nakedninja-design/Wifi-Plant-Watering-System/STL files Boxy/Box.stl

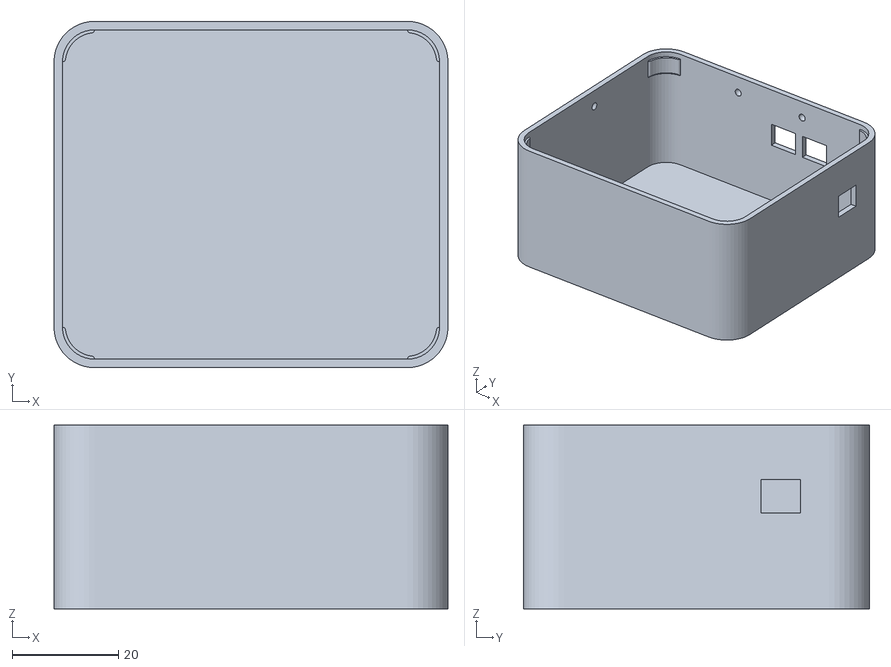
[picture p1: CAD file, 2020-06-12]
STL files Boxy/Box.stl
74.2 x 65.2 x 34.6
