nakedninja-design/Wifi-Plant-Watering-System/STL files Toby/Push Buttons.stl

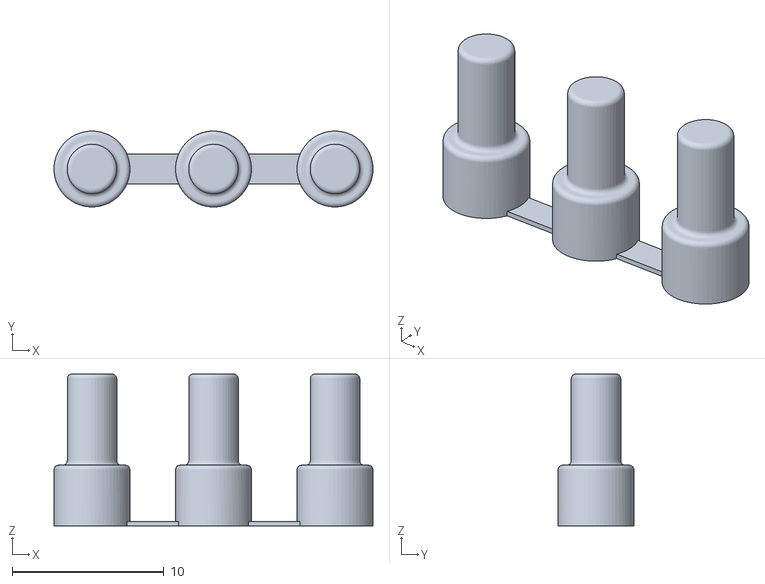
[picture p2: CAD file, 2020-06-12]
STL files Toby/Push Buttons.stl
21.0 x 5.00 x 10.00
