nakedninja-design/Wifi-Plant-Watering-System/STL files Boxy/Front.stl

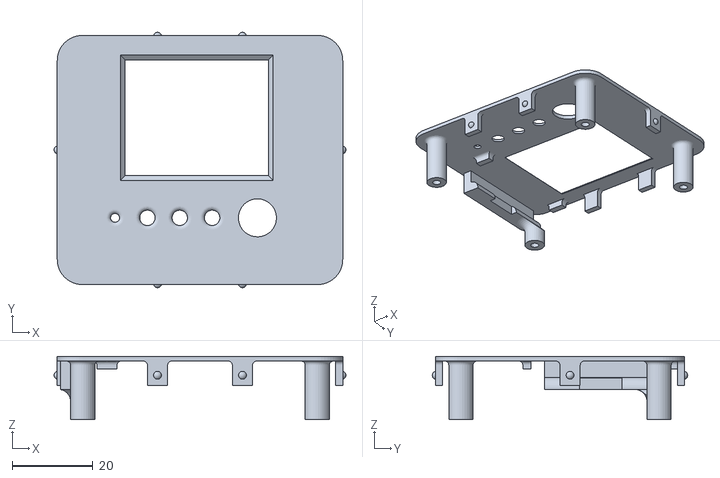
[picture p3: CAD file, 2020-06-12]
STL files Boxy/Front.stl
72.2 x 63.2 x 15.7
