nakedninja-design/Wifi-Plant-Watering-System/STL files Toby/Potmeter Cap.stl

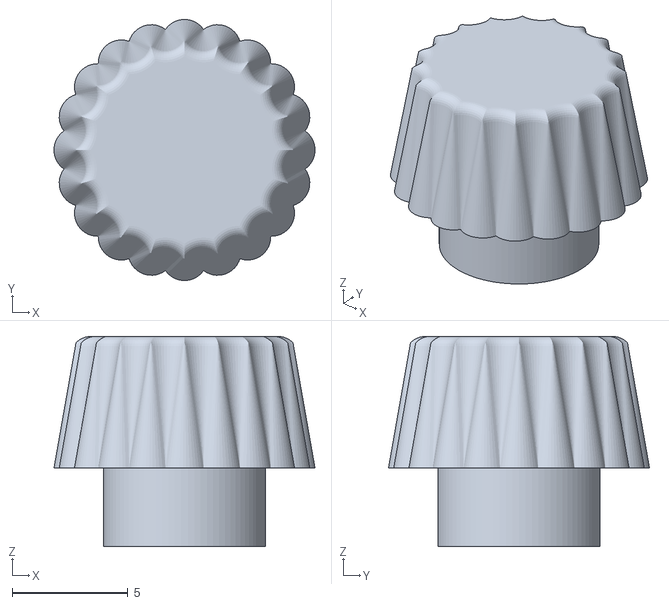
[picture p4: CAD file, 2020-06-12]
STL files Toby/Potmeter Cap.stl
11.3 x 11.3 x 9.07
