nakedninja-design/Wifi-Plant-Watering-System/STL files Toby/Enclosure Top.stl

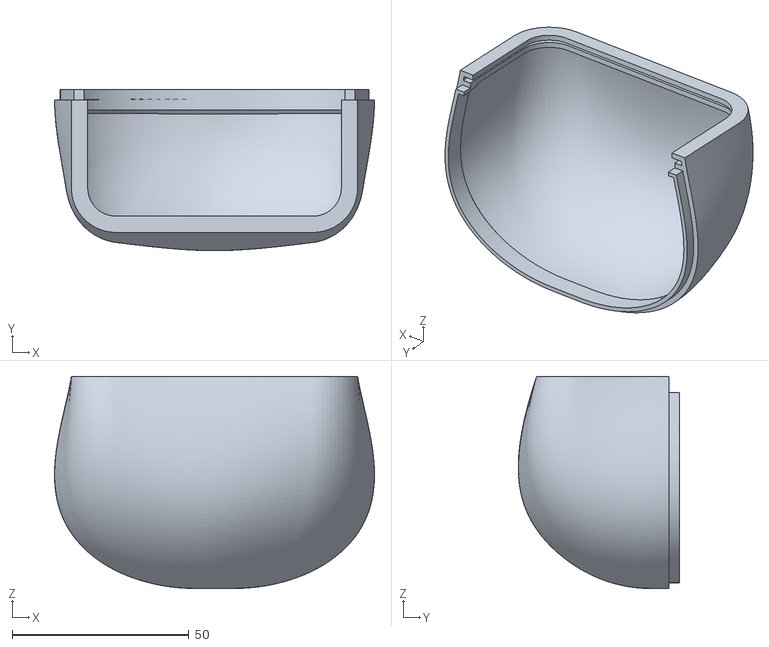
[picture p5: CAD file, 2020-06-12]
STL files Toby/Enclosure Top.stl
90.5 x 45.6 x 60.0
