nakedninja-design/Wifi-Plant-Watering-System/STL files Toby/Frontplate.stl

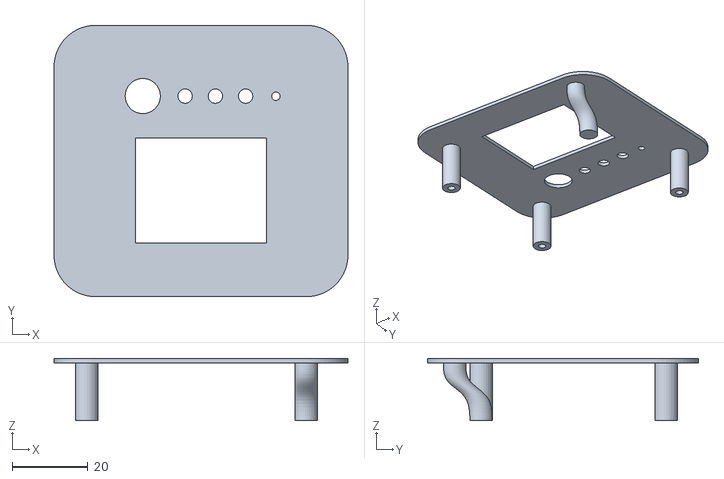
[picture p6: CAD file, 2020-06-12]
STL files Toby/Frontplate.stl
77.7 x 71.7 x 16.4
