nakedninja-design/Wifi-Plant-Watering-System/STL files Toby/Enclosure Bottom.stl

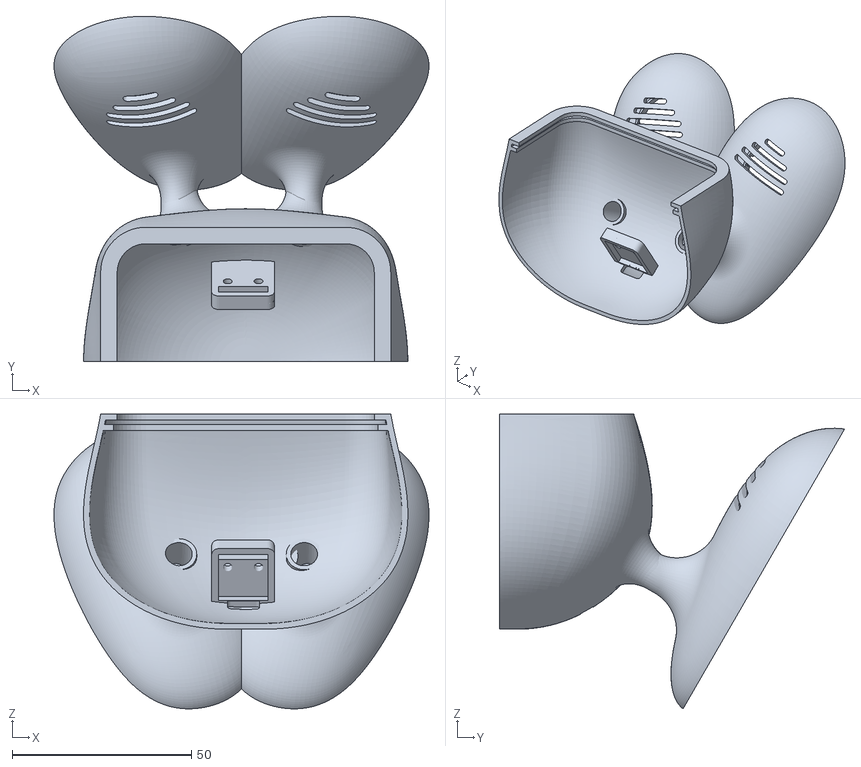
[picture p7: CAD file, 2020-06-12]
STL files Toby/Enclosure Bottom.stl
104.6 x 96.3 x 82.2
