nakedninja-design/Wifi-Plant-Watering-System/STL files Toby/Speaker Mount.stl

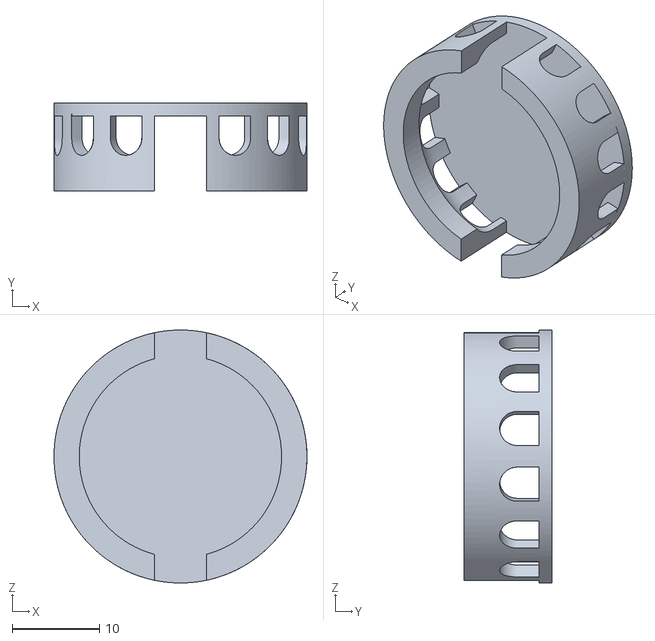
[picture p8: CAD file, 2020-06-12]
STL files Toby/Speaker Mount.stl
29.0 x 10.1 x 29.0
