nakedninja-design/Wifi-Plant-Watering-System/STL files Toby/3d printing instructions.txt

The Speaker Mount needs to printed twice.

The Enclosure Bottom needs to be positioned with its feet flat on the build plate.

The Enclosure Top needs to positioned with its curved side on the build plate and the opening turned upwards in a 45 degree angle. You need to use a raft type build plated adhesion for the Enclosure Top.
