nakedninja-design/Wifi-Plant-Watering-System/(commit log)

2020-06-12 Create 3d printing instructions.txt
2020-06-12 Update 3d printing instructions.txt
